NoileExe/HC-05_BT-HID_retro_gamepad/README.MD

# Bluetooth Classic Gamepad на Arduino / LGT8F328P

Открытый геймпад с поддержкой **SEGA Genesis/Mega Drive 2**, **SEGA Saturn**, **NES** и **SNES** исполнений, работающий через **Bluetooth HID** (модули HC-05 с прошивкой RN-42 или оригинальный RN-42) с управлением через Arduino/LGT8F328P. Питается от аккумулятора, имеет энергосберегающие режимы и защиту от разряда.  

В студенческие годы я накопил коллекцию недорогих проводных геймпадов в стиле старых консолей — но кабели мешали играть даже с USB-удлинителем 2 метра. Недавно решил дать им вторую жизнь: превратить в беспроводные через Bluetooth HID. Этот проект — результат сбора информации по крупицам, экспериментов с энергосбережением и постепенного наращивания функционала.

Теперь любой старый геймпад может стать автономным, энергоэффективным и совместимым с PC/Android через стандартный Bluetooth HID.  

[**Более подробная галлерея устройства геймпадов (Google Drive)**](https://drive.google.com/drive/folders/1TSR5GM3Im5bheJPBD8lp89p7eeVfEJa_)

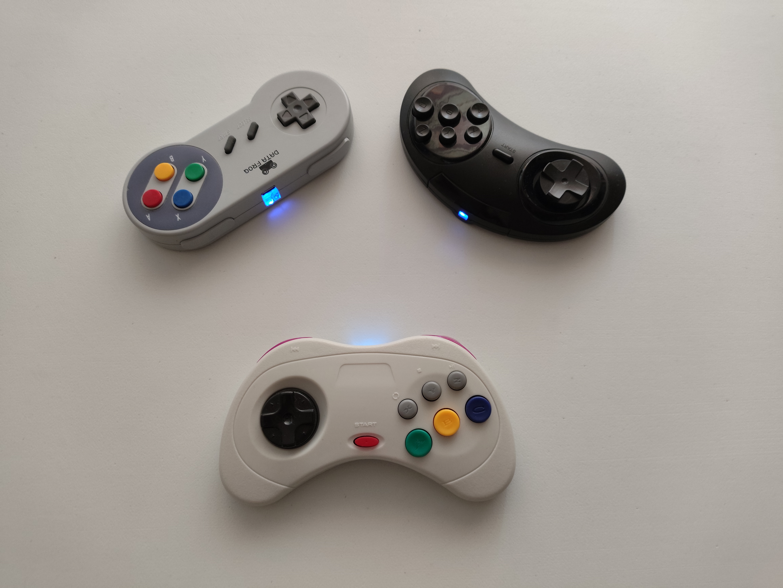
[picture p1: docs/gamepad_trio_bt.jpg]
Троица беспроводных геймпадов
  
*Готовые переделанные геймпады **(SEGA MD2, SEGA Saturn и SNES исполнение)***  

## ✨ Особенности
- **Четыре режима исполнения**: SEGA MD2/Saturn (7-9 кнопок + D-Pad) / NES/SNES (4-8 кнопок + D-Pad)
- **Энергосбережение**:
  - Рабочий режим: до 35 мА
  - Поиск соединения: до 40 мА
  - Глубокий сон: Arduino с 8МГц менее 10 мкА, LGT8F328P ~50 мкА
- **Умное управление питанием**:
  - Контроль напряжения каждые 10 сек
  - Световая индикация при разряде ниже 3.3В
  - Индикация с блокировкой использования при напряжении батареи ниже 3.1В
  - Автоотключение при отсутствии сопряжения >2 мин (BT-модуль в режиме поиска)
  - Автоотключение при простое >5 мин (не нажималась ни одна кнопка)
  - Комбинация для принудительного сна (удержание 3 сек): **D-Pad DOWN + A + B**
  - Комбинация для смены режима геймпада Standard/Turbo/Slow (удержание 3 сек): **D-Pad UP + A + B**
  - Возможность настроить Turbo-функционал для отдельно взятых кнопок (для fightpad-подобных геймпадов и геймпадов с дублирующими Turbo-кнопками - требует изменения кода)
- **Управление Bluetooth**:
  - Проверка статуса подключения каждые 10 сек
  - Полное отключение BT-модуля путём отключения преобразователя напряжения
- **Надёжность**:
  - Watchdog против зависаний
  - Защита от зависаний BT-модуля переводом геймпада в сон

## 📁 Структура проекта
```
REPO
├── HC-05_BT-HID_retro_gamepad/		# Скетч Arduino и прочие части системы .h/.cpp
├── docs/							# Изображения и доп. инструкции
├── .gitignore
├── LICENSE
├── CHANGELOG.MD
└── README.MD
```

## 🧩 Необходимые компоненты
- **Геймпад**: геймпад для модификации
- **Микроконтроллер**: Arduino Pro Mini (желательно 3.3 В / 8 МГц) **или** LGT8F328P Pro Mini
- **BT-модуль**: HC-05 / HC-06 (с прошивкой RN-42) **или** оригинальный RN-42
- **Модуль заряда аккумулятора**: например, TP4056 Type-C
- **Аккумулятор**: Li-Ion/Li-Po 3.7 Вольт, ≥400 мА·ч
- Преобразователь напряжения и компоненты для его сборки (напр., SOT23-5 LDO и SMD конденсаторы)
- Резисторы, светодиоды и провода

## ⚙️ Иные требования
- **IDE**: Arduino IDE
- **Библиотеки**:
  - [GyverLibs/GTimer](https://github.com/GyverLibs/GTimer)
  - [GyverLibs/Blinker](https://github.com/GyverLibs/GyverBlinker)
  - [LaZsolt/Arduino_Vcc](https://github.com/LaZsolt/Arduino_Vcc) (LGPLv2.1)
  - Для Arduino желательно (**обязательно для ATmega328PB**): [MiniCore](https://github.com/mcudude/minicore) (GPLv2)
  - Для LGT8F328P: [LGT8Fx Boards](https://github.com/dbuezas/lgt8fx)

## 🛠 Сборка скетча
1. Установите зависимости через Library Manager
2. Выберите схему подключения кнопок в gamepadConfig.h:
   ```cpp
   // ВЫБОР РЕЖИМА ГЕЙМПАДА - SEGA Genesis/MD2/Saturn либо NES или SNES
   #define SEGA_JOY   // или
   //#define NES_JOY  // или
   //#define SNES_JOY
   ```
3. По желанию воспользуйтесь экспериментальной функцией полной базовой настройки HID-профиля с установкой имени. Для этого установите имя устройства в gamepadConfig.h (занимает примерно 10 секунд):
   ```cpp
   // ИМЯ BT-УСТРОЙСТВА (RN-42 поддерживает имена длиной не более 20 символов; можно с пробелами)
   #define GAMEPAD_NAME "My_Gamepad_001"
   ```
4. Для более точного измерения напряжения воспользуйтесь отладкой PowerManager::readVoltage() (gamepadPowerManager.cpp) с последующей настройкой значения при инициализации члена PowerManager:: measureVoltage в конструкторе PowerManager::PowerManager
5. При наличии дублирующих Turbo-кнопок или переключателя/переключателей для включения Turbo режима см. пример в readButtonsWithTurbo() (HC-05_BT-HID_retro_gamepad.ino)
6. Загрузите скетч через Arduino IDE

> ***Проект протестирован на Android и Windows 10 с поддержкой Bluetooth HID (эмуляторы).***

## 🔌 Подключение
- **TX/RX**: Arduino <--> BT-модуль (логика 3.3 Вольта! ЖЕЛАТЕЛЬНО установить резисторный делитель)
- **BTSTAT_PIN**: Arduino <--> GPIO-2 BT-модуля (HIGH = подключено, LOW = нет соединения)
- **PWRLED_PIN**: мигает при низком напряжении (<3.3 В)  
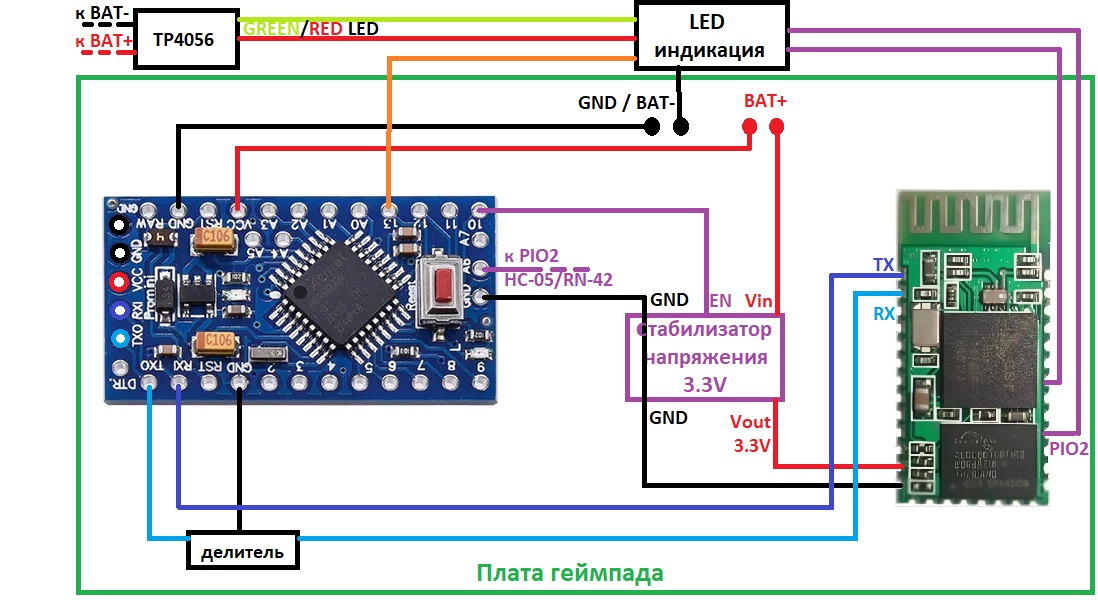
[picture p2: docs/gamepad_schematic.jpg]
Схема соединения модулей
    
*Схема подключения модулей*  

- **Схема подключения кнопок** (перенастроить можно задав свои в getButtonPin в gamepadConfig.h). *Все кнопки срабатывают на логический нуль (LOW)*
> ⚠️ Пины D6/D7 на ATmega328P/PA склонны к ложным срабатываниям — рекомендуется переназначить на аналоговые входы (A4/A5). Либо можете попробовать с предложенными исправлениями, которые в теории решают проблему, но у меня не осталось микроконтреллеров старой серии, чтобы проверить.  

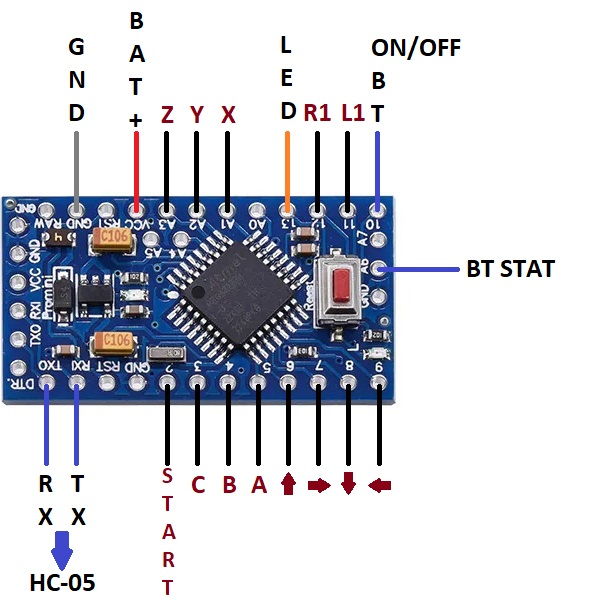
[picture p3: docs/sega_pins.jpg]
Схема подключения pin'ов SEGA
    
*Схема подключения кнопок к Arduino **(SEGA исполнение)***  
  
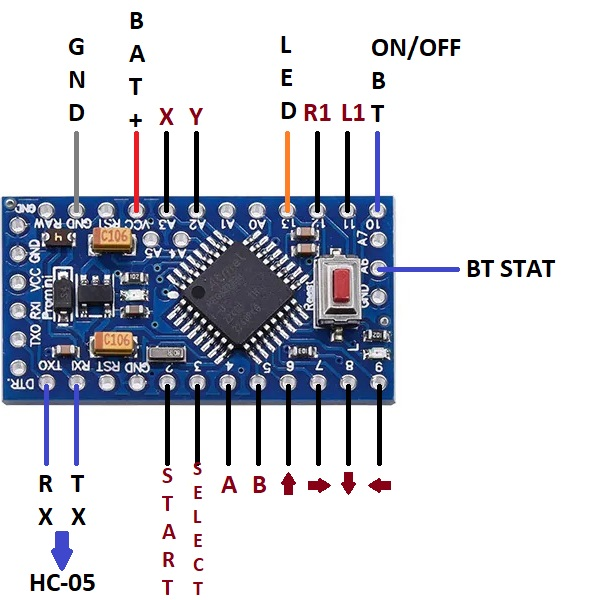
[picture p4: docs/snes_pins.jpg]
Схема подключения pin'ов SNES
  
*Схема подключения кнопок к Arduino **(SNES исполнение)***  

## 🔄 Изменения
[**См. CHANGELOG.MD**](CHANGELOG.MD)  

## 🙏 Благодарности
Evan Kale — за первоначальную идею портирования прошивки с RN-42 на HC-05, которая дала старт развитию проекта.  
Brian Lough — за подробные инструкции по прошивке модулей HC-05/HC-06 через FTDI-программатор: [📹 видео-гайд](https://www.youtube.com/watch?v=y8PcNbAA6AQ)  
Stanislav Parhomovich — за базовую концепцию и вдохновение: [📹 исходное видео](https://www.youtube.com/watch?v=KQtUBw8x6do)  
AlexGyver — за выдающиеся уроки и библиотеки, которые значительно упрощают разработку на Arduino: [🛠️ GyverLibs](https://github.com/GyverLibs)  
Сообществу энтузиастов — за сохранение и публикацию архивных прошивок в открытом доступе 🤝

## 💡 Идеи для ваших pet-проектов
1. Переписать проект с использованием того же BT-модуля, но на другом МК без встроенного Bluetooth (напр., STM32)
2. Переписать [прошивку HID-Keyboard/Mouse для BT-модуля HM-10](https://github.com/rampadc/cc254x-hidKbdM) под HID-геймпад и сделать проект на его основе
3. Переписать скетч под использование аналоговых стиков и триггеров с использованием мультиплексора вроде CD74HC4067 для "увеличения" количества пинов Arduino

## 📄 Лицензия
- **Код** распространяется под лицензией [**GNU GPL v3+**](LICENSE).  
  (для обеспечения открытости образовательного контента; предназначен исключительно для демонстрации навыков работы с embedded-системами, энергосбережением и Bluetooth HID).

- **Схемы и документация** — свободны для **некоммерческого использования** при обязательном указании источника.
