NoileExe/HC-05_BT-HID_retro_gamepad/docs/gamepad_trio_bt_2.jpg

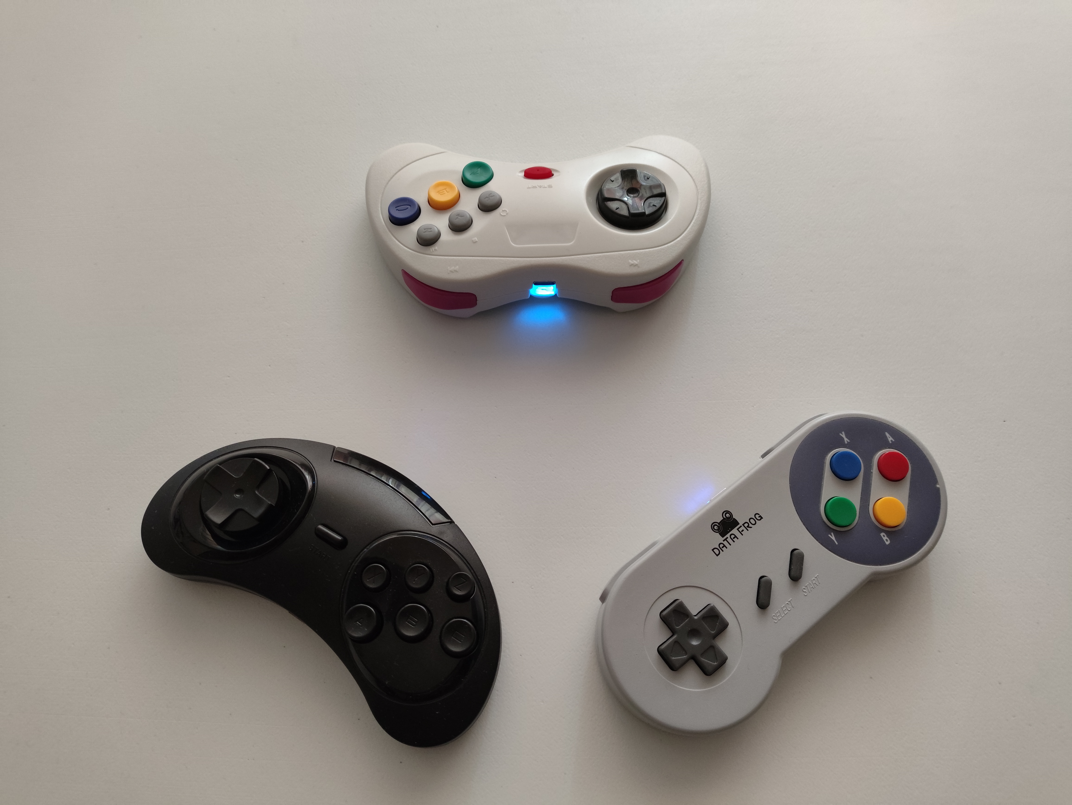
docs/gamepad_trio_bt_2.jpg
