NoileExe/HC-05_BT-HID_retro_gamepad/docs/sega_wired.jpg

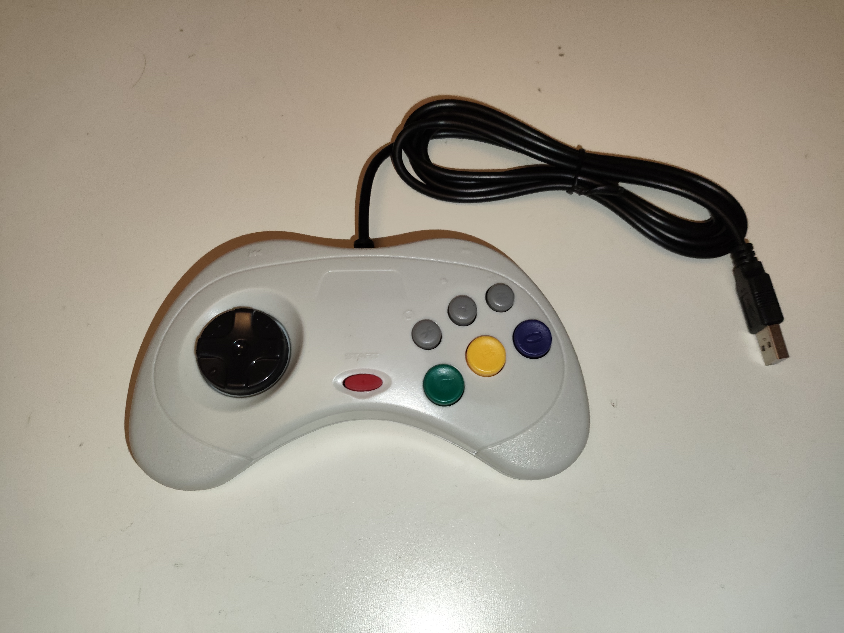
docs/sega_wired.jpg
