NoileExe/HC-05_BT-HID_retro_gamepad/CHANGELOG.MD

# Changelog
> Даты релизов не фиксировались. Указаны версии в хронологическом порядке.

## [v1.3.1]
### Refactor
- Блок чтения дублирующих Turbo-кнопок вынесен в отдельную чистую функцию `readButtonsWithTurbo()` (готов к замене основной логики при необходимости)
### Internal
- Косметические изменения репозитория: изменения вынесены в CHANGELOG.MD, добавлен раздел с благодарностями

## [v1.3.0]
### Added
- Возможность вешать Turbo-функционал на отдельно взятые кнопки

## [v1.2.1]
### Changed
- В связи с изменениями дополнена [**PDF-инструкция по сборке**](docs/HC-05_BT-HID_retro_gamepad_HOWTO.pdf)
- Переход на единую для ATmega и LGT8F328P библиотеку измерения опорного напряжения на пине VCC
- Унификация комбинаций перехода в сон/смены режимов для разных геймпадов (Sega/NES/SNES)
### Fixed
- Глубокий сон для LGT8F328P
- Мелкие правки, в том числе логики измерения напряжения

## [v1.2.0]
### Added
- [**Полноценная подробная PDF-инструкция по сборке**](docs/HC-05_BT-HID_retro_gamepad_HOWTO.pdf)
- Добавлены режимы работы геймпада: помимо привычного Standard, появился Turbo (быстрое многократное нажатие кнопок действий) и режим Slow (быстрое нажатие кнопки START, что позволяет в играх на консолях 8/16-бит упростить прохождение динамичных сцен)
- Добавлен профиль NES
- Установка базовых настроек HID-профиля и имени устройства через программное взаимодействие с BT-модулем (полезно при первом запуске)
### Changed
- Модульный рефакторинг, вынос BT-логики в отдельную многофункциональную "библиотеку"
- Работа с BT-модулем дополнена программным взаимодействием
- Переход на более лёгкую и современную библиотеку GTimer взамен архивной TimerMs

## [v1.1.0]
### Changed
- Доработка режимов сна
- Уменьшение задержек таймеров
- Отказ от программного управления BT-модулем
- Пересмотр логики работы таймеров и комбинаций
### Fixed
- Фикс измерения напряжения LGT8F328P
- Программная попытка решить проблему D6/D7 на старых ATmega

## [v1.0.0]
### Added
- Первый релиз: поддержка SEGA/SNES, Bluetooth HID, энергосбережение, программное управление BT-модулем
