NoileExe/HC-05_BT-HID_retro_gamepad/HC-05_BT-HID_retro_gamepad/gamepadPowerManager.cpp

/*
 * HC-05_BT-HID_retro_gamepad
 * Firmware for a retro gamepad (SEGA Genesis/MD2/Saturn or SNES) based on Arduino Pro Mini
 * or LGT8F328P, emulating a Bluetooth HID device via HC-05 module flashed with RN-42 firmware
 * (or original RN-42 module).
 * Copyright (C) 2026 Belobragin Anton Igorevich
 *
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
 * You should have received a copy of the GNU General Public License
 * along with this program.  If not, see <https://www.gnu.org/licenses/>.
 */

//------------------------------------------------------------------

#pragma once


#include <Arduino.h>

#ifdef __LGT8FX8P__
	#include <lgt_LowPower.h>
	#include <WDT.h>
#else
	#include <avr/sleep.h>
	#include <avr/power.h>
	#include <avr/wdt.h>
#endif

#include "gamepadPowerManager.h"
#include "gamepadConfig.h"

//------------------------------------------------------------------

// Инициализация статических членов
void (*PowerManager::preSleepCallback)() = nullptr;
void (*PowerManager::wakeupCallback)() = nullptr;

// Статическая функция-прослойка
void PowerManager::isrStub()
{
	if (wakeupCallback)
		wakeupCallback();
}

void PowerManager::setPreSleepCallback(void (*callback)())
{
	preSleepCallback = callback;
}

void PowerManager::setWakeupCallback(void (*callback)())
{
	wakeupCallback = callback;
}

//------------------------------------------------------------------

PowerManager::PowerManager(uint8_t wakeUpPin)
	: currentState(false)
	, lastConnectedState(0)
	, measureVoltage(3.300f/3.300f)		// Измеренное мультиметром Vcc разделенное на Vcc, которое сообщил readVoltage()
	, currentVoltage(5.0)
	, lastVoltageCheck(0)
	, powerLed(PWRLED_PIN)
	, interrupt_pin(wakeUpPin)
{
}

void PowerManager::begin()
{
	pinMode(BT_ONOFF_PIN, OUTPUT);
	digitalWrite(BT_ONOFF_PIN, HIGH);	//Включаем преобразователь напряжения на модуле BT


	pinMode(BT_STAT_PIN, INPUT);

#if defined(ADC6D) && defined(ADC7D)
	if (BT_STAT_PIN == A6 || BT_STAT_PIN == A7)
	{
		// Отключить цифровой буфер (нет утечки - LED не светится во сне)
		DIDR0 |= _BV(ADC6D);
		DIDR0 |= _BV(ADC7D);
	}
#endif


	// Отключаем OC0A после инициализации в ПОПЫТКЕ ПОЧИНИТЬ проблему D6
	// К сожалению, плат на ATMEGA328P/PA у меня для проверки не осталось
	TCCR0A &= ~(_BV(COM0A0) | _BV(COM0A1));

	//Слежение за зависанием самой ардуинки. Таймаут установлен максимальный ~8с
#ifdef __LGT8FX8P__
	ACSR = _BV(C0D);	//Отключаем компаратор в ПОПЫТКЕ ПОЧИНИТЬ проблему D7 и для снижения потребления
	wdt_enable(WTO_8S);
#else
	ACSR = _BV(ACD);	//Отключаем компаратор в ПОПЫТКЕ ПОЧИНИТЬ проблему D7 и для снижения потребления
	wdt_enable(WDTO_8S);
#endif

	Serial.begin(9600);

	lastConnectedState = millis();
	lastVoltageCheck = millis() - VOLTAGE_CHECK_MS;
}




void PowerManager::watchdog_reset()
{
	wdt_reset();
}

void PowerManager::watchdog_enable(bool enabled /*= true*/)
{
	if (enabled)
	{
#ifdef __LGT8FX8P__
		wdt_enable(WTO_8S);
#else
		wdt_enable(WDTO_8S);
#endif
	}
	else
	{
		wdt_disable();
	}
}


void PowerManager::tick()
{
	checkConnection();
	checkBattery();
	
	wdt_reset();
}

//------------------------------------------------------------------

bool PowerManager::readConnectionState()
{
	currentState = analogRead(BT_STAT_PIN) > 500;	//Примерно половина от максимального значения 1023
													// (при 10 битах analogReadResolution() - значение по умолчанию)
	return currentState;
}

void PowerManager::checkConnection()
{
	uint32_t now = millis();
	readConnectionState();

	if (currentState)
		lastConnectedState = now;
	else if (INACTIVITY_DISCONNECTED_MS < (now - lastConnectedState))
	{
		sleep();
	}
}

//------------------------------------------------------------------

float PowerManager::readVoltage()
{
	currentVoltage = measureVoltage.Read_Volts();

	//Отладка измерения напряжения
	//Serial.println(currentVoltage, 3);
	//Serial.print("*****\n");

	return currentVoltage;
}

void PowerManager::checkBattery()
{
	uint32_t now = millis();
	if (VOLTAGE_CHECK_MS < (now - lastVoltageCheck))
	{
		lastVoltageCheck = now;
		readVoltage();
		
		// Критический разряд: быстро мигаем и уходим в глубокий сон до зарядки
		// Не даем пользоваться устройством пока батарея не будет заряжена
		while (currentVoltage <= VOLTAGE_CRITICAL_LEVEL)
		{
			digitalWrite(BT_ONOFF_PIN, LOW);	//Выключаем преобразователь напряжения на модуле BT
			Serial.end();
			pinMode(RX_PIN, INPUT);				// RX в High-Z (высокий импеданс)
			digitalWrite(TX_PIN, LOW);			// Принудительно 0 на TX
			pinMode(TX_PIN, OUTPUT);			// TX как выход 0Вольт
			
			indicateCritical();
			sleep();
			
			// Читаем при пробуждении
			readVoltage();
		}
		
		
		if (currentVoltage < (VOLTAGE_WARNING_LEVEL - VOLTAGE_ACCURACY_LEVEL))
			indicateWarning();
		
		// Напряжение в норме – гасим светодиод
		else if (powerLed.running())
			powerLed.stop();
	}
	
	// Даже если не проверяем напряжение, поддерживаем мигание светодиода
	else if (powerLed.running())
		powerLed.tick();
}

void PowerManager::indicateWarning()
{
	// Предупреждение: медленное мигание (2000 мс вкл / 500 мс выкл)
	if (!powerLed.running())
		powerLed.blinkForever(2000, 500);
	
	powerLed.tick();
}

void PowerManager::indicateCritical()
{
	powerLed.stop();
	
	for (int i = 0; i < 3; ++i)
	{
		powerLed.blink(4, 300, 300);	// мигнуть 4 раза, 300мс вкл, 300мс выкл
		
		while (!powerLed.ready())
		{
			powerLed.tick();
			wdt_reset();
			delay(50);
		}
		
		delay(1000);
	}
}

//------------------------------------------------------------------

void PowerManager::sleep()
{
	// Вызываем пользовательскую подготовку перед сном
	if (preSleepCallback)
	{
		preSleepCallback();
	}

	digitalWrite(BT_ONOFF_PIN, LOW); //Выключаем преобразователь напряжения на модуле BT
	Serial.end();
	pinMode(RX_PIN, INPUT);			// RX в High-Z (высокий импеданс)
	digitalWrite(TX_PIN, LOW);		// Принудительно 0 на TX
	pinMode(TX_PIN, OUTPUT);		// TX как выход 0Вольт

	digitalWrite(PWRLED_PIN, LOW);

	wdt_disable();

#ifdef __LGT8FX8P__
	// АЦП + сброс флага
	ADCSRA &= ~_BV(ADEN);
	ADCSRA |= _BV(ADIF);

	ADCSRD = 0x00;	// Полное отключение аналога

	// LVD (Low Voltage Detector)
	VDTCR |= _BV(WCE);
	VDTCR &= ~_BV(VDTEN);

	PRR = _BV(PRADC) /*| _BV(PRTIM0)*/ | _BV(PRTIM1) | _BV(PRTIM2) | _BV(PRUSART0) | _BV(PRSPI) | _BV(PRTWI);
	// Бит 1 (PRPCI) НЕ трогаем — нужно для пробуждения по кнопке!
	//     PRTIM3    PRWDT    PREFL
	PRR1 = _BV(3) | _BV(5) | _BV(2);

	DIDR0 = 0xFF;	// Цифровые входы на аналоговых пинах на время сна отключены
	DIDR1 = 0xFF;

	EIFR = 0xFF;
	attachInterrupt(digitalPinToInterrupt(interrupt_pin), isrStub, LOW);
	LowPower.powerDown(SLEEP_FOREVER, ADC_OFF, BOD_OFF);	// Переводим МК в спящий режим
															// (DPS2 экономичнее, но при пробуждении он перезагрузит МК,а так же он не сохраняет состояние пинов. 
															// Т.е. в данном исполнении без изменения схемы будет утечка,при которой будет питаться LDO BT-модуля, 
															// что будет создавать огромное потребление в режиме сна)
#else
	ADMUX = 0;
	ADCSRA &= ~_BV(ADEN);	// Отключаем АЦП

	PRR_NAME = _BV(PRADC) /*| _BV(PRTIM0)*/ | _BV(PRTIM1) | _BV(PRTIM2) | _BV(PRUSART_BIT_NAME) | _BV(PRSPI_BIT_NAME) | _BV(PRTWI_BIT_NAME);
	#ifdef PRR1
		//     PRTIM3    PRDAC   PRSPI1   PRTWI1
		PRR1 = _BV(0) | _BV(3) | _BV(1) | _BV(2);
	#endif

	DIDR0 = 0xFF;							// Цифровые входы на аналоговых пинах на время сна отключены
	DIDR1 = 0xFF;

	set_sleep_mode(SLEEP_MODE_PWR_DOWN);	//Устанавливаем интересующий нас режим

	cli();									// Временно запрещаем обработку прерываний
	sleep_enable();
	
	//Очистка флагов прерываний
	if (interrupt_pin == 2)			EIFR = _BV(INTF0);
	else if (interrupt_pin == 3)	EIFR = _BV(INTF1);

	//Выход из режима сна по нажатию кнопки на указанном пине (обычно 2ой пин - кнопка START)
	// Перевод цифрового пина в номер пина с прерыванием (для ATmega D2 == 0, D3 == 1)
	attachInterrupt(digitalPinToInterrupt(interrupt_pin), isrStub, LOW);
	sei();											// Разрешаем обработку прерываний
	
	sleep_bod_disable();							// Отключаем детектор пониженного напряжения питания
	sleep_cpu();									// Переводим МК в спящий режим
#endif

	wake();
}

void PowerManager::wake()
{
#ifdef __LGT8FX8P__
	PRR = 0;
	PRR1 = 0;
	DIDR0 = 0;
	DIDR1 = 0;
	ADCSRA |= _BV(ADEN);	// Если нужен АЦП
	ADCSRD |= _BV(ADEN);	// Разрешаем работу АЦП (бит 0)

	VDTCR |= _BV(WCE);
	VDTCR |= _BV(VDTEN);	// Включаем детектор

	wdt_enable(WTO_8S);		//Слежение за зависанием самого МК. Таймаут установлен максимальный ~8с
#else
	// ПРОСНУЛИСЬ
	sleep_disable();

	PRR_NAME = 0;
	#ifdef PRR1
		PRR1 = 0;
	#endif

	DIDR0 = 0;
	DIDR1 = 0;

	ADCSRA |= _BV(ADEN);

	wdt_enable(WDTO_8S);	//Слежение за зависанием самого МК. Таймаут установлен максимальный ~8с
#endif

	// Перевод цифрового пина в номер пина с прерыванием (для ATmega D2 == 0, D3 == 1)
	detachInterrupt( digitalPinToInterrupt(interrupt_pin) );

	digitalWrite(BT_ONOFF_PIN, HIGH);	//Включаем преобразователь напряжения на модуле BT
	Serial.begin(9600);
	delay(500);

	currentState = false;
	lastConnectedState = millis();
	lastVoltageCheck = millis() - VOLTAGE_CHECK_MS;

#if defined(ADC6D) && defined(ADC7D)
	if (BT_STAT_PIN == A6 || BT_STAT_PIN == A7)
	{
		// Отключить цифровой буфер (нет утечки - LED не светится во сне)
		DIDR0 |= _BV(ADC6D);
		DIDR0 |= _BV(ADC7D);
	}
#endif

	// Ожидаем пока кнопку отпустят
	while (digitalRead(interrupt_pin) == LOW)
	{
		delay(10);
	}
}
