NoileExe/HC-05_BT-HID_retro_gamepad/(commit log)

2026-04-12 refine sleep modes, timers, voltage reading, and pin stability
    [HC-05_BT-HID_retro_gamepad.ino]
2026-05-03 Unify voltage measurement library and sleep/mode combos, update PDF guide, fix LGT8F328P deep sleep
    [HC-05_BT-HID_retro_gamepad.ino, gamepadConfig.h, gamepadPowerManager.cpp, gamepadPowerManager.h]
2026-05-03 Add per-button turbo functionality
2026-05-19 refactor: extract logic for duplicate turbo buttons into readButtonsWithTurbo(); update changelog and credits
